hsoft/musicbox/schematics/musicbox.pdf

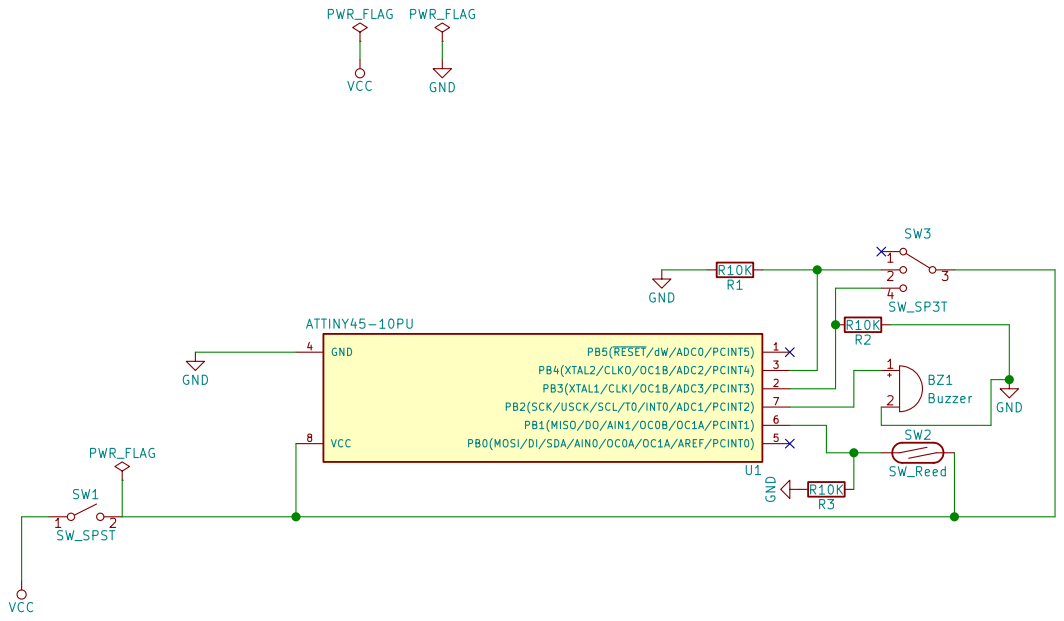
[picture p1: page 1]

Id: 1/1 Title: File: musicbox.sch Sheet: /
