hsoft/musicbox/kicad/musicbox.sch

## KiCad design kicad/musicbox.sch (2017-08-18)

Schematic: musicbox.sch

Parts:
BZ1: Buzzer
R1, R2, R3: R10K
SW1: SW_SPST
SW2: SW_Reed
SW3: SW_SP3T
U1: ATTINY45-10PU; DIP-8_W7.62mm
