hsoft/musicbox/src/tune.h

#pragma once

#include "../common/pin.h"

#define NOTE_PAUSE 1
#define NOTE_B3 247
#define NOTE_C4 262
#define NOTE_D4 294
#define NOTE_E4 330
#define NOTE_F4 349
#define NOTE_G4 392
#define NOTE_A4 440
#define NOTE_B4 494
#define NOTE_C5 523
#define NOTE_C5S 554
#define NOTE_D5 587
#define NOTE_E5 659
#define NOTE_F5 698
#define NOTE_G5 784
#define NOTE_A5 880
#define NOTE_B5 988
#define NOTE_C6 1047
#define NOTE_D6 1175

typedef unsigned int Tune[];

void play_note(Pin pin, unsigned int frequency);
void play_tune(Pin pin, Tune tune);
