hsoft/musicbox/(commit log)

2017-08-18 Add KiCAD schematics
    [musicbox.sch]
2017-08-19 Add song selector support!
    In this commit, I have painfully learned about AVR's RAM limits. I
    couldn't understand why my program would crash. It took me hours to
    pinpoint RAM overflow and learn about PROGMEM.
    [main.c]
2017-08-21 Add assembly instructions
2017-08-29 Send pin and util to a new avr-common subrepo
